vladislav06/MESH/README.md

# DSAN
Distributed Sensor Actuator Network
Logo Title Text 1
