vladislav06/MESH/MESH-pcb/MESH.kicad_pcb

## KiCad design MESH-pcb/MESH.kicad_pcb (2025-03-19)

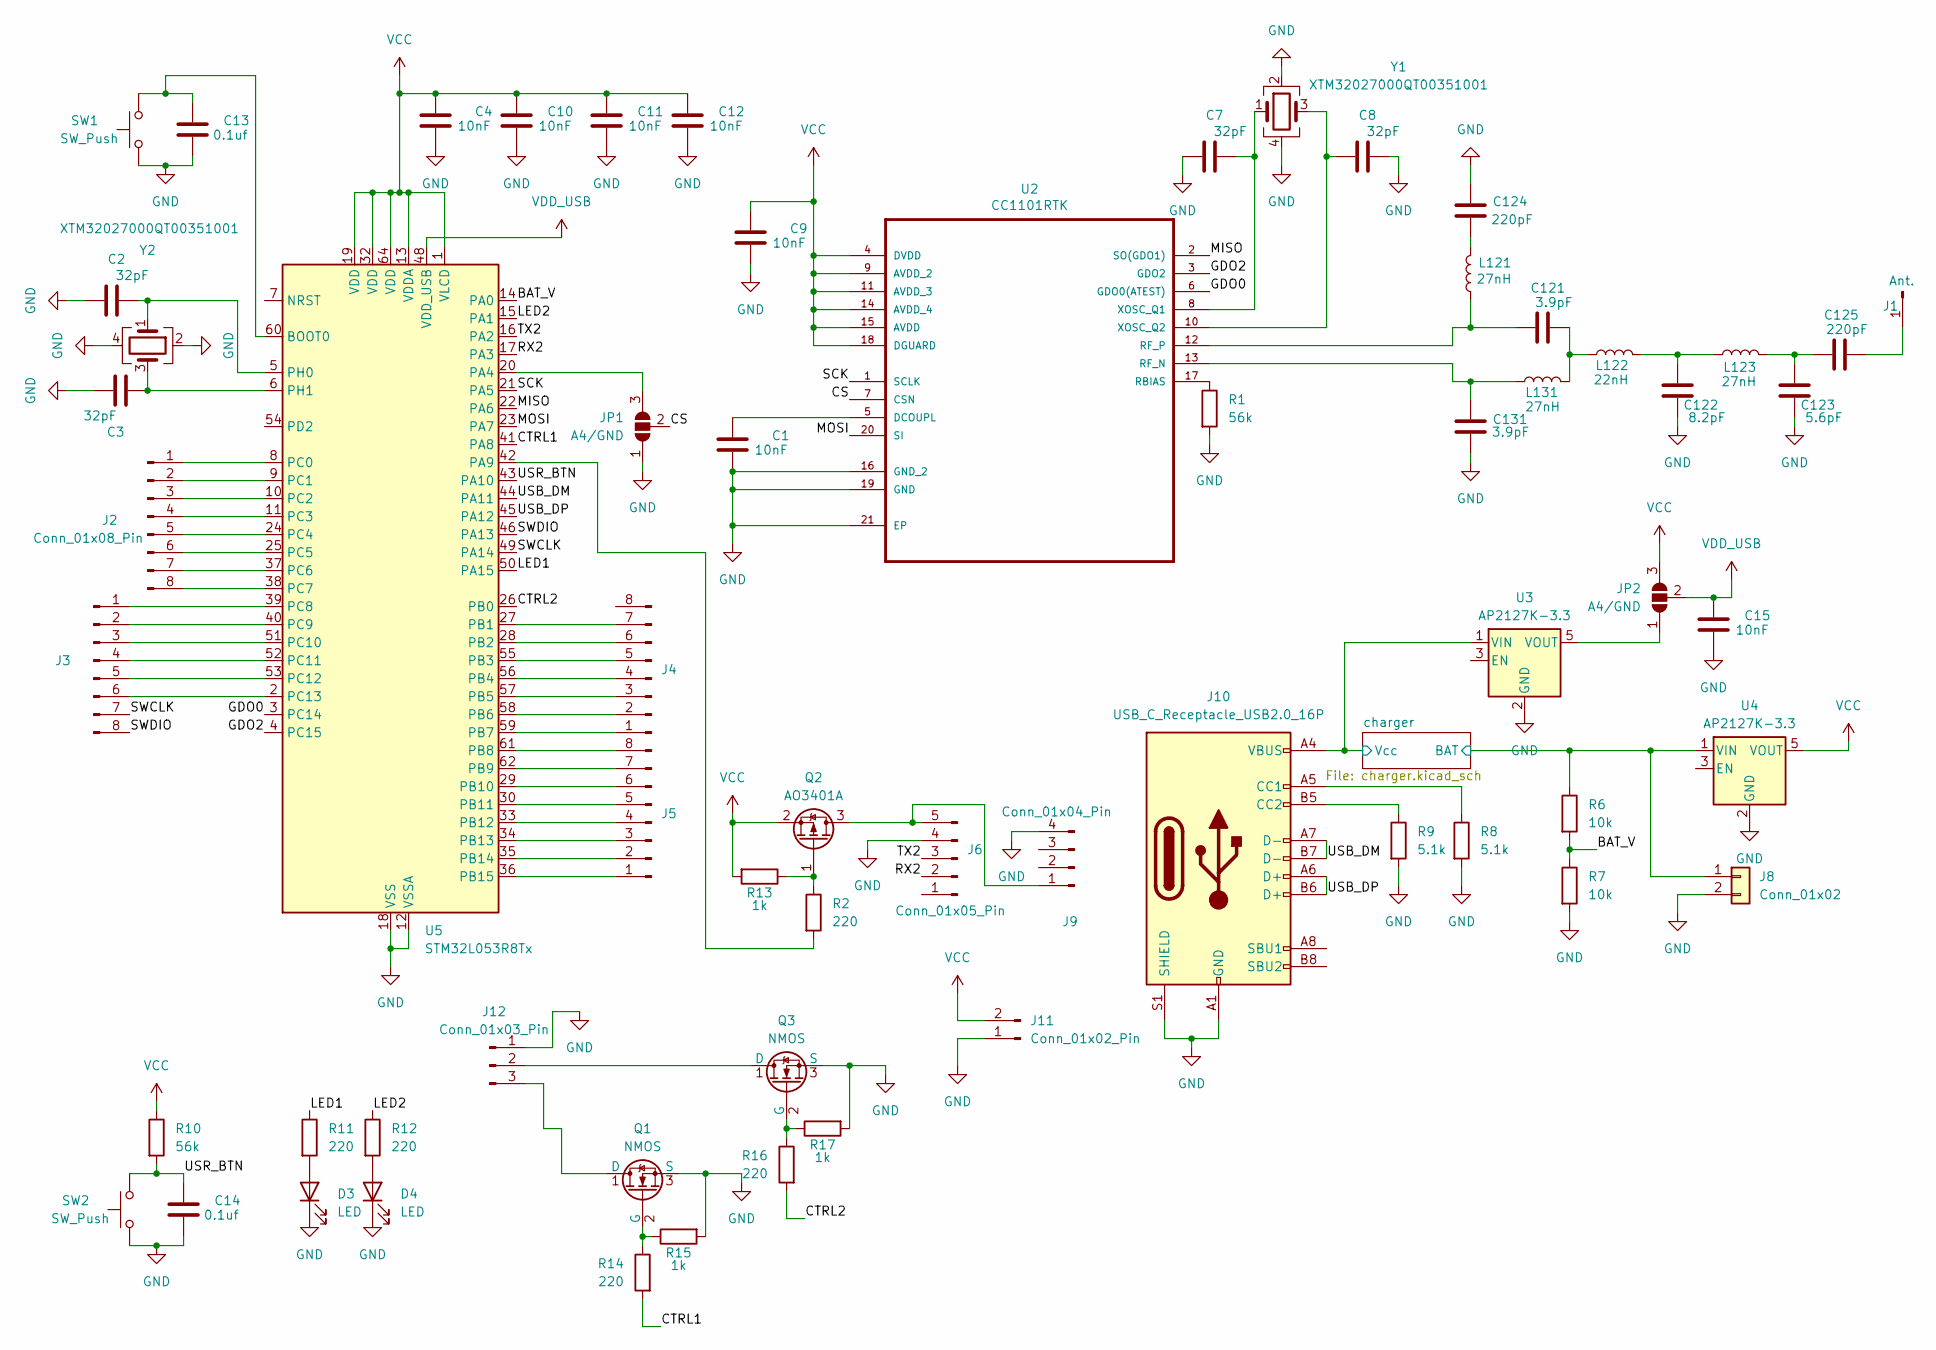
[picture p1: schematic MESH.kicad_sch]

Parts:
C1, C4, C9, C10, C11, C12, C15: 10nF; C_0402_1005Metric
C2, C3, C7, C8: 32pF; C_0402_1005Metric
C13, C14: 0.1uf; C_0402_1005Metric
C121, C131: 3.9pF; C_0402_1005Metric
C122: 8.2pF; C_0402_1005Metric
C123: 5.6pF; C_0402_1005Metric
C124, C125: 220pF; C_0402_1005Metric
D3, D4: LED; LED_0603_1608Metric_Pad1.05x0.95mm_HandSolder
J1: Ant.; PinHeader_1x01_P1.00mm_Vertical
J2, J3, J4, J5: Conn_01x08_Pin; PinHeader_1x08_P2.54mm_Bare
J6: Conn_01x05_Pin; PinHeader_1x05_P1.00mm_Vertical
J8: Conn_01x02; PinHeader_1x02_P2.54mm_Vertical
J9: Conn_01x04_Pin; PinHeader_1x04_P2.00mm_Vertical
J10: USB_C_Receptacle_USB2.0_16P; USB_C_Receptacle_Palconn_UTC16-G
J11: Conn_01x02_Pin; PinHeader_1x02_P2.54mm_Bare
J12: Conn_01x03_Pin; PinHeader_1x03_P2.54mm_Bare
JP1, JP2: A4/GND; SolderJumper-3_P2.0mm_Open_TrianglePad1.0x1.5mm_NumberLabels
L121, L123, L131: 27nH; L_0402_1005Metric
L122: 22nH; L_0402_1005Metric
Q1, Q3: NMOS; SOIC127P600X175-8N
Q2: AO3401A; SOT-23
R1, R10: 56k; R_0201_0603Metric_Pad0.64x0.40mm_HandSolder
R2, R11, R12, R14, R16: 220; R_0201_0603Metric_Pad0.64x0.40mm_HandSolder
R6, R7: 10k; R_0201_0603Metric_Pad0.64x0.40mm_HandSolder
R8, R9: 5.1k; R_0201_0603Metric_Pad0.64x0.40mm_HandSolder
R13, R15, R17: 1k; R_0201_0603Metric_Pad0.64x0.40mm_HandSolder
SW1, SW2: SW_Push; SW_5.6_3.1
U2: CC1101RTK; QFN-20-1EP_4x4mm_P0.5mm_EP2.5x2.5mm
U3, U4: AP2127K-3.3; SOT-23-5
U5: STM32L053R8Tx; LQFP-64_10x10mm_P0.5mm
Y1, Y2: XTM32027000QT00351001; Crystal_SMD_3225-4Pin_3.2x2.5mm_HandSoldering

Connections:
/BAT_V: R6.2, R7.1, U5.14 (PA0)
/CS: JP1.2 (C), U2.7 (CSN)
/CTRL1: R14.2, U5.41 (PA8)
/CTRL2: R16.2, U5.26 (PB0)
/GDO0: U2.6 (GDO0(ATEST)), U5.3 (PC14)
/GDO2: U2.3 (GDO2), U5.4 (PC15)
/LED1: R11.1, U5.50 (PA15)
/LED2: R12.1, U5.15 (PA1)
/MISO: U2.2 (SO(GDO1)), U5.22 (PA6)
/MOSI: U2.20 (SI), U5.23 (PA7)
/RX2: J6.2, U5.17 (PA3)
/SCK: U2.1 (SCLK), U5.21 (PA5)
/SWCLK: J3.7, U5.49 (PA14)
/SWDIO: J3.8, U5.46 (PA13)
/TX2: J6.3, U5.16 (PA2)
/USB_DM: J10.A7 (D-), J10.B7 (D-), U5.44 (PA11)
/USB_DP: J10.A6 (D+), J10.B6 (D+), U5.45 (PA12)
/USR_BTN: C14.1, R10.2, SW2.2, U5.43 (PA10)
/charger/BAT: J8.1, R6.1, U4.1 (VIN); also elsewhere on the board
/charger/Vcc: J10.A4 (VBUS), J10.A9 (VBUS), J10.B4 (VBUS), J10.B9 (VBUS), U3.1 (VIN); also elsewhere on the board
GND: C1.2, C2.1, C3.2, C4.2, C7.1, C8.2, C9.2, C10.2, C11.2, C12.2, C13.2, C14.2, C15.2, C122.2, C123.2, C124.1, C131.2, D3.1 (K), D4.1 (K), J6.4, J8.2, J9.4, J10.A1 (GND), J10.A12 (GND), J10.B1 (GND), J10.B12 (GND), J10.S1 (SHIELD), J11.1, J12.1, JP1.1 (A), Q1.3 (S), Q3.3 (S), R1.2, R7.2, R8.2, R9.2, R15.2, R17.2, SW1.1, SW2.1, U2.16 (GND_2), U2.19 (GND), U2.21 (EP), U3.2 (GND), U4.2 (GND), U5.12 (VSSA), U5.18 (VSS), U5.31 (VSS), U5.47 (VSS), U5.63 (VSS), Y1.2, Y1.4, Y2.2, Y2.4; also elsewhere on the board
unnamed: C121.2, L122.1, L131.2
unnamed: C122.1, L122.2, L123.1
unnamed: C123.1, C125.1, L123.2
unnamed: C124.2, L121.2
unnamed: D3.2 (A), R11.2
unnamed: D4.2 (A), R12.2
unnamed: C125.2, J1.1
unnamed: J2.1, U5.8 (PC0)
unnamed: J2.2, U5.9 (PC1)
unnamed: J2.3, U5.10 (PC2)
unnamed: J2.4, U5.11 (PC3)
unnamed: J2.5, U5.24 (PC4)
unnamed: J2.6, U5.25 (PC5)
unnamed: J2.7, U5.37 (PC6)
unnamed: J2.8, U5.38 (PC7)
unnamed: J3.1, U5.39 (PC8)
unnamed: J3.2, U5.40 (PC9)
unnamed: J3.3, U5.51 (PC10)
unnamed: J3.4, U5.52 (PC11)
unnamed: J3.5, U5.53 (PC12)
unnamed: J3.6, U5.2 (PC13)
unnamed: J4.1, U5.59 (PB7)
unnamed: J4.2, U5.58 (PB6)
unnamed: J4.3, U5.57 (PB5)
unnamed: J4.4, U5.56 (PB4)
unnamed: J4.5, U5.55 (PB3)
unnamed: J4.6, U5.28 (PB2)
unnamed: J4.7, U5.27 (PB1)
unnamed: J5.1, U5.36 (PB15)
unnamed: J5.2, U5.35 (PB14)
unnamed: J5.3, U5.34 (PB13)
unnamed: J5.4, U5.33 (PB12)
unnamed: J5.5, U5.30 (PB11)
unnamed: J5.6, U5.29 (PB10)
unnamed: J5.7, U5.62 (PB9)
unnamed: J5.8, U5.61 (PB8)
unnamed: J6.5, J9.1, Q2.3 (D)
unnamed: J10.A5 (CC1), R8.1
unnamed: J10.B5 (CC2), R9.1
unnamed: J12.2, Q3.1 (D)
unnamed: J12.3, Q1.1 (D)
unnamed: JP1.3 (B), U5.20 (PA4)
unnamed: JP2.1 (A), U3.5 (VOUT)
unnamed: Q1.2 (G), R14.1, R15.1
unnamed: Q2.1 (G), R2.1, R13.1
unnamed: Q3.2 (G), R16.1, R17.1
unnamed: C1.1, U2.5 (DCOUPL)
unnamed: R1.1, U2.17 (RBIAS)
unnamed: C131.1, L131.1, U2.13 (RF_N)
unnamed: C121.1, L121.1, U2.12 (RF_P)
unnamed: C7.2, U2.8 (XOSC_Q1), Y1.1
unnamed: C8.1, U2.10 (XOSC_Q2), Y1.3
unnamed: C13.1, SW1.2, U5.60 (BOOT0)
unnamed: R2.2, U5.42 (PA9)
unnamed: C2.2, U5.5 (PH0), Y2.1
unnamed: C3.1, U5.6 (PH1), Y2.3
VCC: C4.1, C9.1, C10.1, C11.1, C12.1, J11.2, JP2.3 (B), Q2.2 (S), R10.1, R13.2, U2.4 (DVDD), U2.9 (AVDD_2), U2.11 (AVDD_3), U2.14 (AVDD_4), U2.15 (AVDD), U2.18 (DGUARD), U4.5 (VOUT), U5.1 (VLCD), U5.13 (VDDA), U5.19 (VDD), U5.32 (VDD), U5.64 (VDD)
VDD_USB: C15.1, JP2.2 (C), U5.48 (VDD_USB)

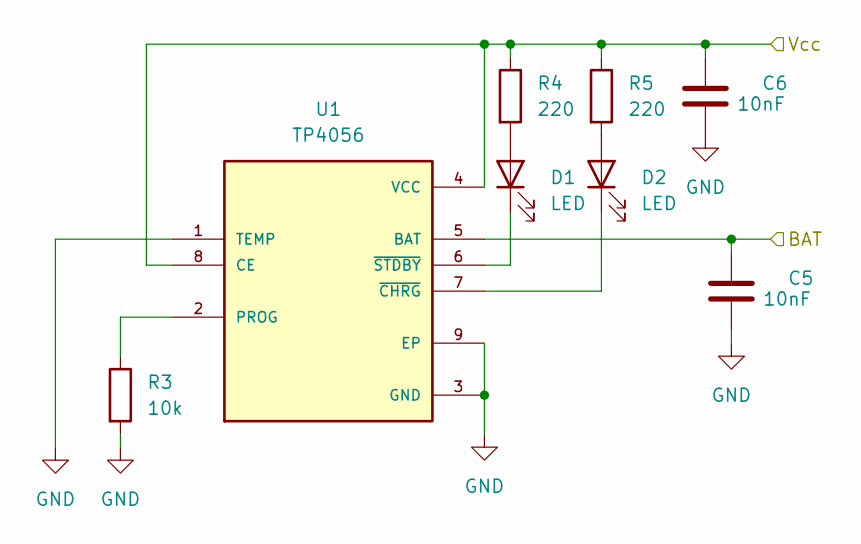
[picture p2: schematic charger.kicad_sch]

Parts:
C5, C6: 10nF; C_0402_1005Metric
D1, D2: LED; LED_0603_1608Metric_Pad1.05x0.95mm_HandSolder
R3: 10k; R_0201_0603Metric_Pad0.64x0.40mm_HandSolder
R4, R5: 220; R_0201_0603Metric_Pad0.64x0.40mm_HandSolder
U1: TP4056; SOP127P600X175-9N

Connections:
/charger/BAT: C5.1, U1.5 (BAT); also elsewhere on the board
/charger/Vcc: C6.1, R4.1, R5.1, U1.4 (VCC), U1.8 (CE); also elsewhere on the board
GND: C5.2, C6.2, R3.2, U1.1 (TEMP), U1.3 (GND), U1.9 (EP); also elsewhere on the board
unnamed: D1.2 (A), R4.2
unnamed: D1.1 (K), U1.6 (~STDBY)
unnamed: D2.2 (A), R5.2
unnamed: D2.1 (K), U1.7 (~CHRG)
unnamed: R3.1, U1.2 (PROG)

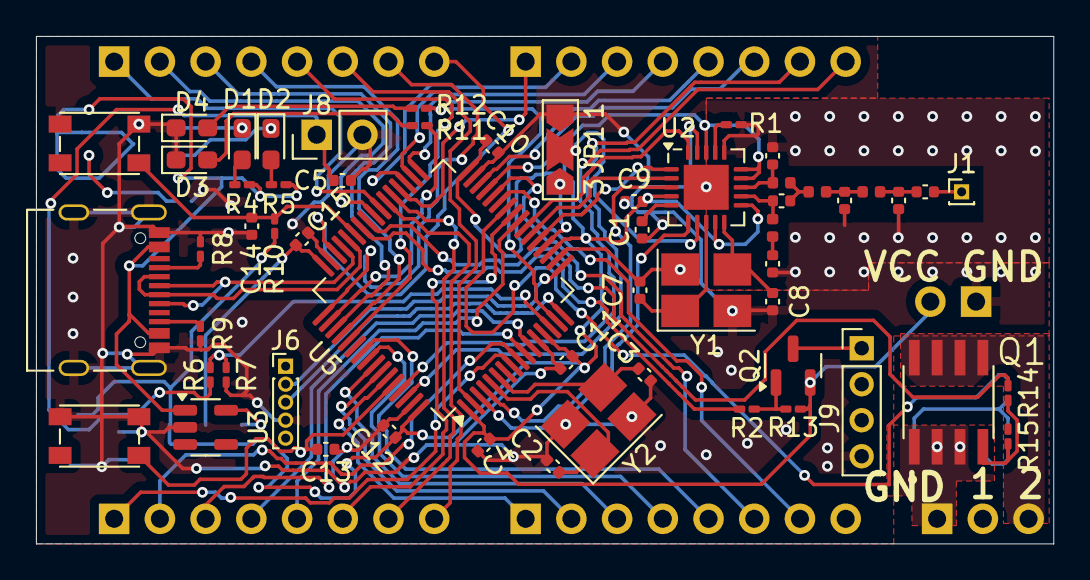
[picture p3: board MESH.kicad_pcb from above]

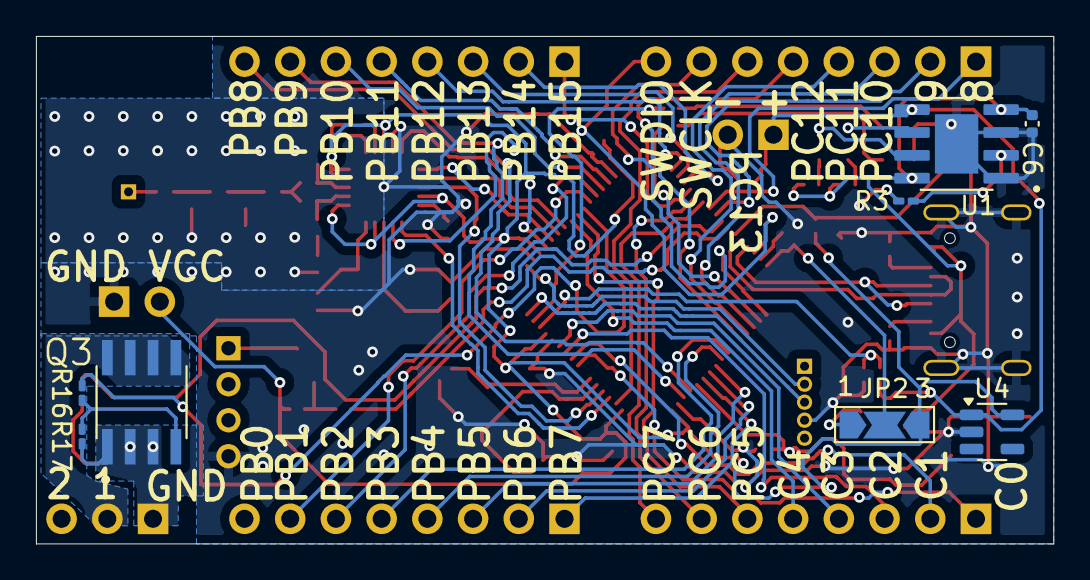
[picture p4: board MESH.kicad_pcb from below]

Board: 2 copper layers, 56.5 x 28.2 mm, 71 parts (8 on the bottom side), 84 nets.
