vladislav06/MESH/MESH-code/Core/Src/main.c

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
/* Includes ------------------------------------------------------------------*/
#include "main.h"
#include "usb_device.h"

/* USER CODE BEGIN Includes */
#include "appMain.h"
#include "usbd_cdc_if.h"
#include <stdio.h>
/* USER CODE END Includes */

ADC_HandleTypeDef hadc;

CRC_HandleTypeDef hcrc;

RNG_HandleTypeDef hrng;

SPI_HandleTypeDef hspi1;

TIM_HandleTypeDef htim6;

UART_HandleTypeDef huart2;

void SystemClock_Config(void);
static void MX_GPIO_Init(void);
static void MX_SPI1_Init(void);
static void MX_USART2_UART_Init(void);
static void MX_TIM6_Init(void);
static void MX_CRC_Init(void);
static void MX_RNG_Init(void);
static void MX_ADC_Init(void);
/**
  * @brief  The application entry point.
  * @retval int
  */
int main(void)
{

  /* MCU Configuration--------------------------------------------------------*/

  /* Reset of all peripherals, Initializes the Flash interface and the Systick. */
  HAL_Init();

  /* Configure the system clock */
  SystemClock_Config();

  /* Initialize all configured peripherals */
  MX_GPIO_Init();
  MX_SPI1_Init();
  MX_USART2_UART_Init();
  MX_USB_DEVICE_Init();
  MX_TIM6_Init();
  MX_CRC_Init();
  MX_RNG_Init();
  MX_ADC_Init();
  /* USER CODE BEGIN 2 */
    appMain(&hadc, &hspi1, 0, &htim6, &huart2,&hcrc,&hrng);
  /* USER CODE END 2 */

  /* Infinite loop */
  /* USER CODE BEGIN WHILE */
    while (1) {
    /* USER CODE END WHILE */

    /* USER CODE BEGIN 3 */
    }
  /* USER CODE END 3 */
}

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
/* USER CODE BEGIN 4 */
int _write(int file, char *ptr, int len) {
    static uint8_t rc = USBD_OK;
    rc = CDC_Transmit_FS(ptr, len);
    HAL_Delay(1);
    if (USBD_FAIL == rc) {
        /// NOTE: Should never reach here.
        /// TODO: Handle this error.
        return 0;
    }
    return len;
}

/* USER CODE END 4 */
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
