vladislav06/MESH/MESH-code/MESH-code.ioc

Mcu.UserName=STM32L053R8Tx
PA0.Signal=ADC_IN0
PA1.Signal=GPIO_Output
PA10.Signal=GPIO_Input
PA11.Signal=USB_DM
PA12.Signal=USB_DP
PA13.Signal=SYS_SWDIO
PA14.Signal=SYS_SWCLK
PA15.Signal=GPIO_Output
PA2.Signal=USART2_TX
PA3.Signal=USART2_RX
PA4.Signal=GPIO_Output
PA5.Signal=SPI1_SCK
PA6.Signal=SPI1_MISO
PA7.Signal=SPI1_MOSI
PA8.Signal=GPIO_Output
PA9.Signal=GPIO_Output
PB0.Signal=GPIO_Output
PB1.Signal=ADC_IN9
PB12.Signal=GPIO_Output
PB13.Signal=GPIO_Output
PC0.Signal=GPIO_Output
PC14-OSC32_IN.Signal=GPXTI14
PC15-OSC32_OUT.Signal=GPXTI15
PC2.Signal=GPIO_Output
PC4.Signal=GPIO_Output
PC6.Signal=GPIO_Output
