vladislav06/MESH/(commit log)

2025-02-23 Schematic update, PCB routing update
    [MESH.kicad_pcb, MESH.kicad_sch, charger.kicad_sch]
2025-03-02 Added custom component library, Almost final component placement
    [MESH.kicad_pcb, MESH.kicad_sch, charger.kicad_sch]
2025-03-10 routing almost complete
    [MESH.kicad_pcb, MESH.kicad_sch, charger.kicad_sch]
2025-03-10 Ready to be exported
    [MESH.kicad_pcb, MESH.kicad_sch, MESH_BOM.csv]
2025-03-17 added pinheader footprint without outline, added pin names to silkscreen
    [MESH.kicad_pcb, MESH.kicad_sch]
2025-03-17 Added all pin names
    [MESH.kicad_pcb, MESH.kicad_sch]
2025-03-19 pcb ordered
    [MESH.kicad_pcb]
2025-04-06 MX project created Ported cc1101 driver from c++ to c Transition works
2025-04-07 Added espProg openocd configuration
    [espProg.cfg]
2025-04-09 Added new pin definitions, Added post generation script
2025-04-11 Added interrupt on pc14 and pc15
2025-04-13 Added ability to transmit long packets asynchronously, async part of driver is ready
2025-04-14 Added ability to receive/transmit synchronously, inside receive interrupt
2025-05-01 Added ability to get current rssi value. Added test stuff.
2025-05-09 Added uart dma
2025-05-11 Added math expression parsing library Added reduced printf uart transmission fix
    [appMain.c]
2025-05-14 base driver for ld2410b sensor
2025-05-14 Fixed utils Added forces ack handing to ld driver
    [appMain.c, ld2410b.c, ld2410b.h, utils.c, utils.h]
2025-05-14 Added tiny printf and expr. Reduced usb buffer sizes
2025-05-26 Added packet definition Added routing table and routing functions Added receive handler Added actuator definition
2025-05-26 Routing fix cc driver fix, added timeout protection wireless communication further implementation
    [MESH-code.ioc, appMain.c, appMain.h, cc1101.c, cc1101.h, main.c, wirelessComms.c]
2025-05-30 Added discovery request and response packets and handling, still buggy
    [MESH-code.ioc, appMain.c, cc1101.c, hw.c, main.c]
2025-05-30 Added CCA and listen before talk routing table print fix
    [appMain.c, cc1101.c, wirelessComms.c]
2025-06-05 base driver for ld2410b sensor - incomplete, WIP
2025-06-06 Removed macro support from expr parser. Added some structures to configuration.h Added stack marking
    [configuration.h]
2025-06-07 expr fixes added configurationLoader for loading configuration from usb
    [configurationLoader.h]
2025-06-07 functional ld2410b driver
2025-06-08 Added adc read support
2025-06-08 Added configuration to eeprom upload
    [configurationLoader.h]
2025-06-08 actuator load config, also fixes for ld2410b driver
    [actuator.c, actuator.h, ld2410b.c, ld2410b.h]
2025-06-08 Added ability to send sensor data to all subscribed nodes
2025-06-08 Fixed algorith length parsing
    [actuator.c, actuator.h]
2025-06-08 actuator handle cd function
2025-06-08 actuator expression evaluate function
2025-06-09 sensor init function declaration and implementation
2025-06-09 final fixes
    [configurationLoader.h]
2025-06-10 Added local configuration loader, custom sensor and actuator configuration metaLanguage
2025-06-10 bug fixes and renaming
    [actuator.c, appMain.c, hw.h, sensor.c, sensor.h, sensorConf.h, sensorImpl.h, wirelessComms.c]
2025-06-11 Added unsubscription More debug info New node added to sensor config
